MarianUrsarescu/Input-Audio-Preamplifier-Circuit-/README.md

For a given dataset, I had to calculate the component values, create the electronic schematic in Orcad, and
transpose it into the PCB editor. Along the way, I performed various circuit simulations to verify its functionality.
