MarianUrsarescu/Input-Audio-Preamplifier-Circuit-/Proiect/schema_bloc.jpg

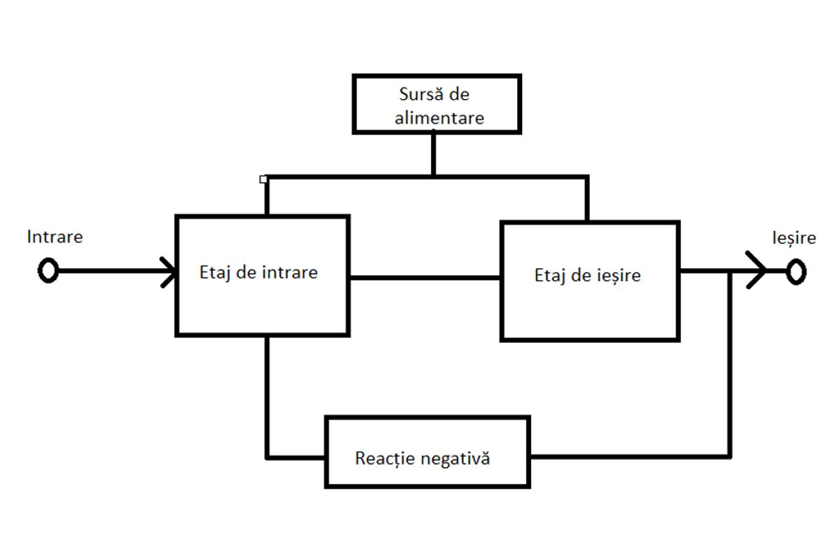
Proiect/schema_bloc.jpg
