MarianUrsarescu/Input-Audio-Preamplifier-Circuit-/(list of files, drawings)

Other design files:
Proiect/Schematics/P1 OrCAD/P1.DSN
Proiect/Schematics/P1 OrCAD/P1.opj
